MrFangao/EspressoMachine/docs/assets/Brew_Animation.jpeg

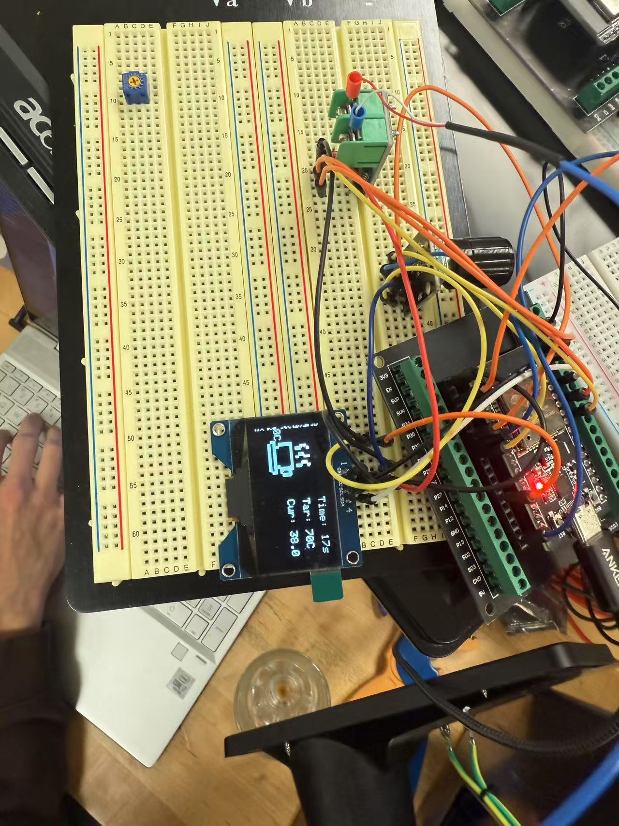
docs/assets/Brew_Animation.jpeg
