MrFangao/EspressoMachine/docs/assets/ControlMenu.jpg

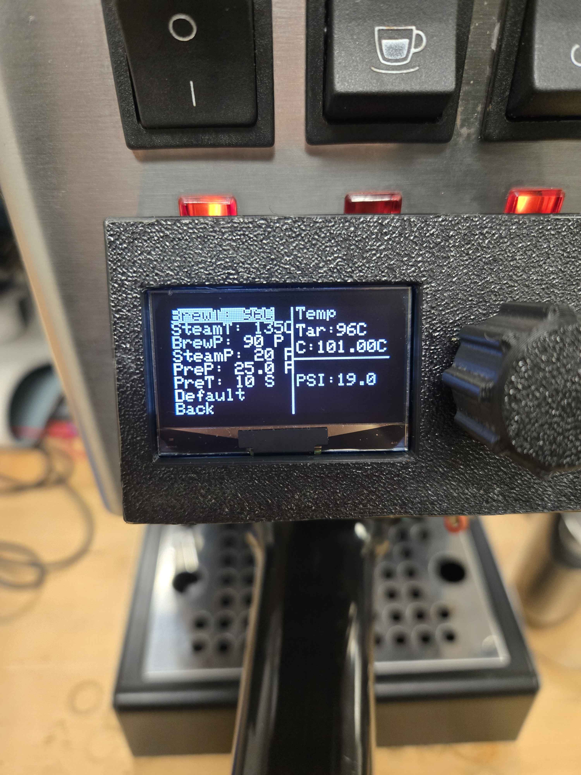
docs/assets/ControlMenu.jpg
