MrFangao/EspressoMachine/docs/assets/GaggiaMain.jpg

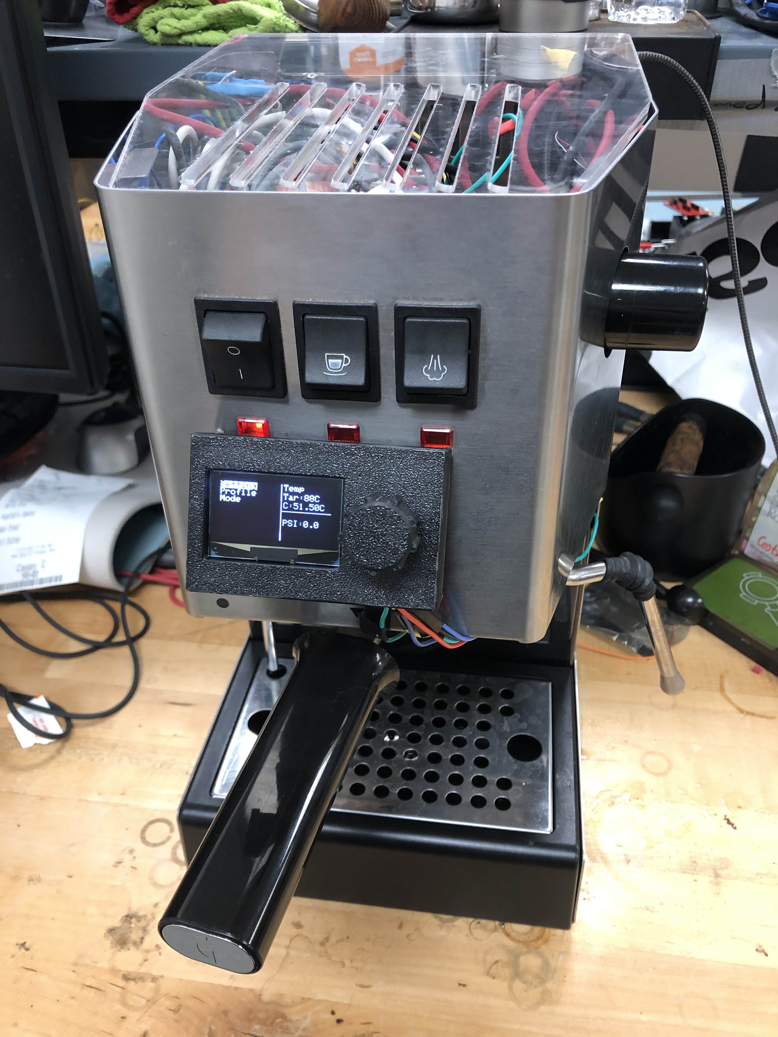
docs/assets/GaggiaMain.jpg
