MrFangao/EspressoMachine/docs/assets/Main_Status.jpeg

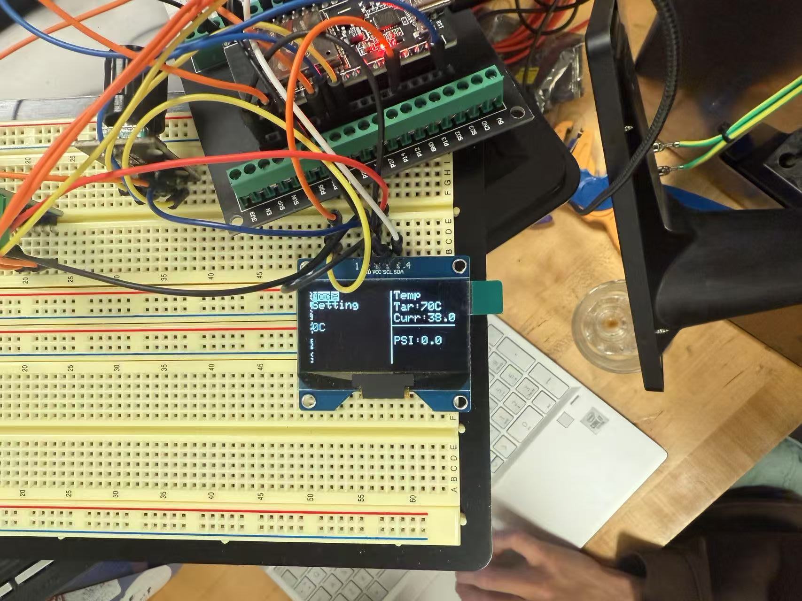
docs/assets/Main_Status.jpeg
