MrFangao/EspressoMachine/docs/assets/MainPage.jpg

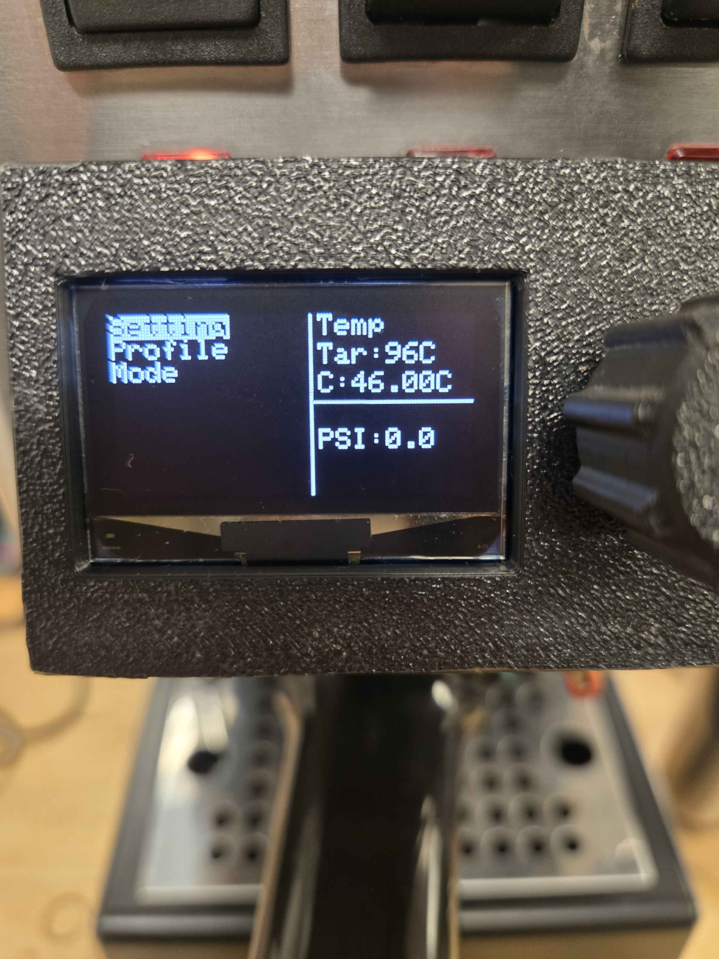
docs/assets/MainPage.jpg
