MrFangao/EspressoMachine/docs/assets/ModeMenu.jpeg

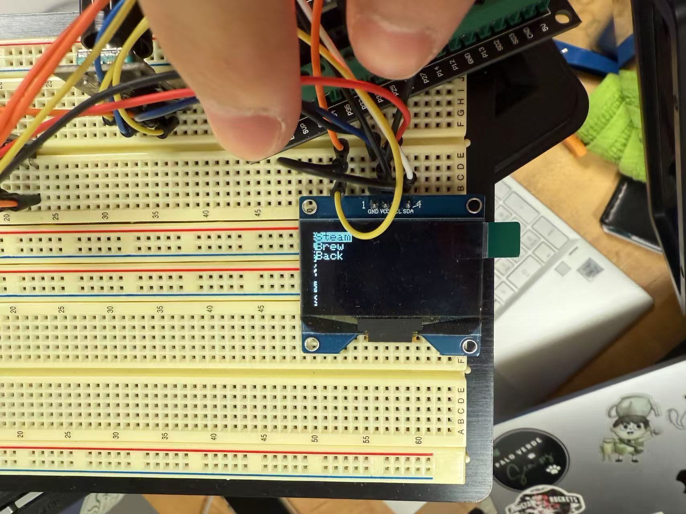
docs/assets/ModeMenu.jpeg
