MrFangao/EspressoMachine/docs/assets/OPModes.jpg

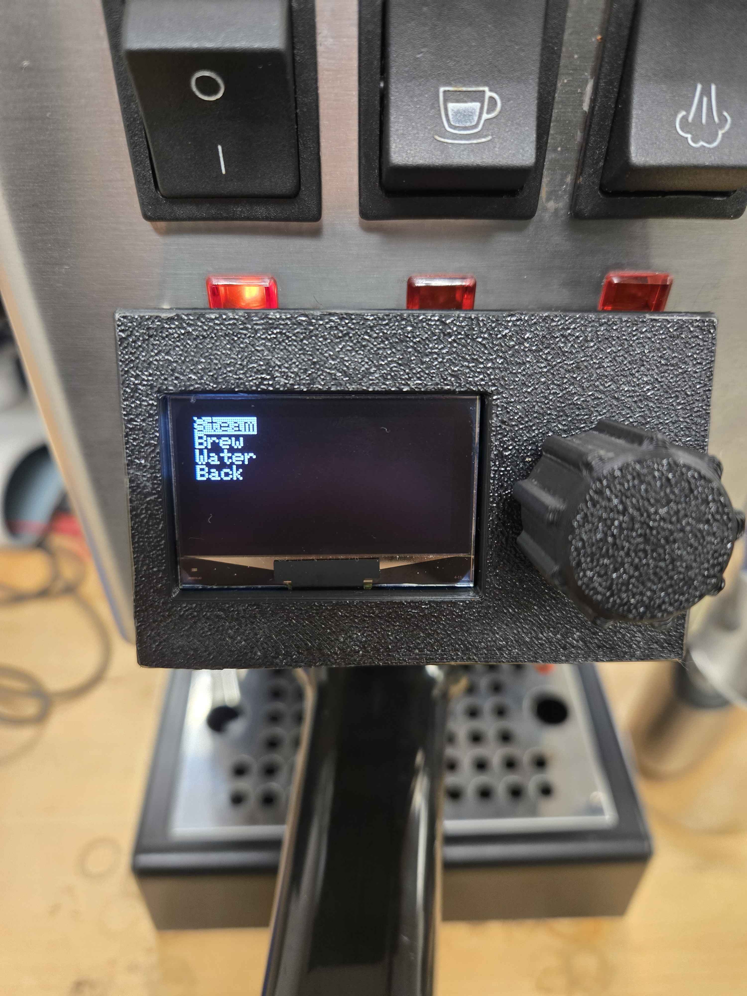
docs/assets/OPModes.jpg
