MrFangao/EspressoMachine/docs/assets/SaveOptions.jpg

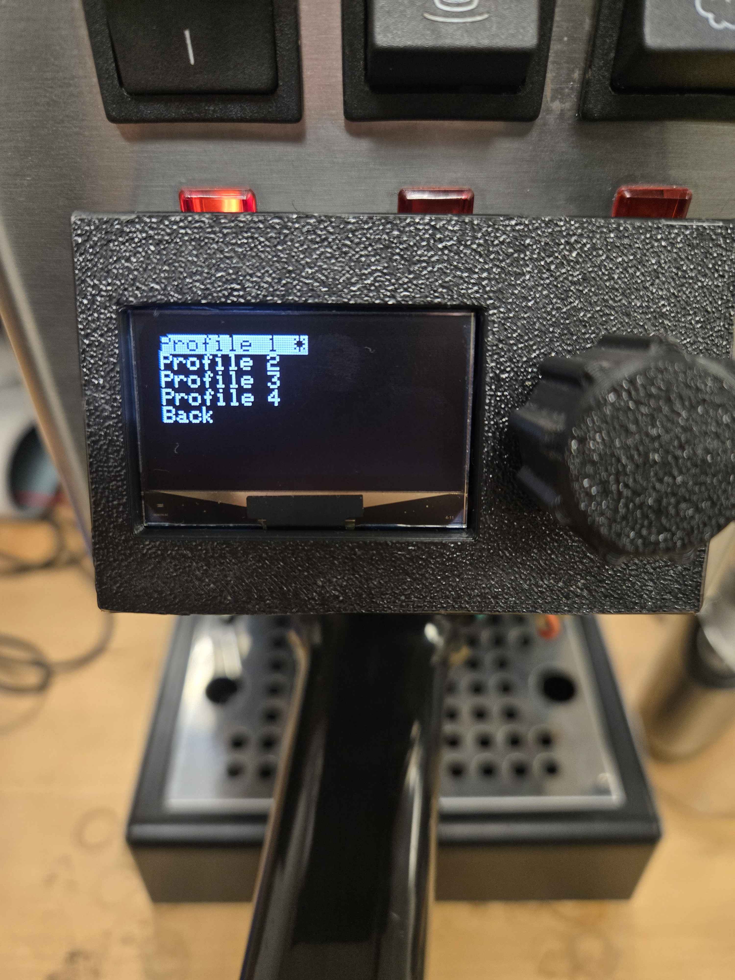
docs/assets/SaveOptions.jpg
