MrFangao/EspressoMachine/docs/assets/SettingMenu.jpeg

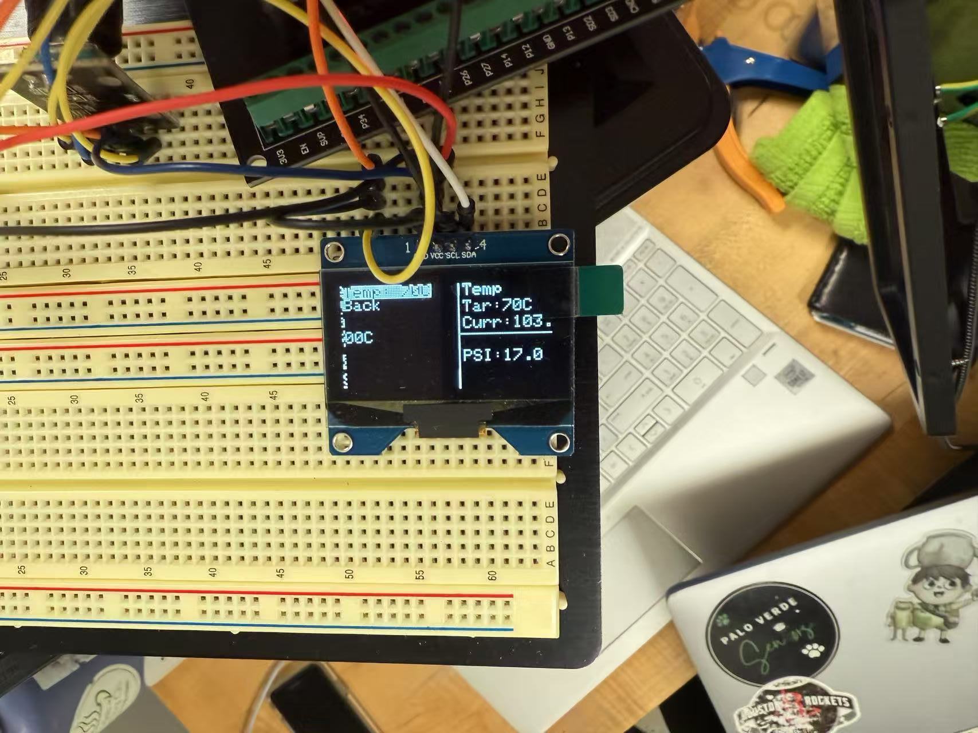
docs/assets/SettingMenu.jpeg
