MrFangao/EspressoMachine/docs/assets/Temp_Press_graph.png

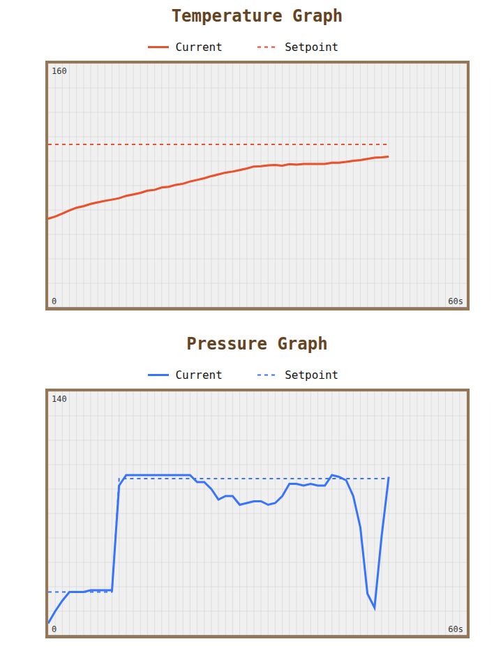
docs/assets/Temp_Press_graph.png
