MrFangao/EspressoMachine/docs/assets/TopDownView.jpg

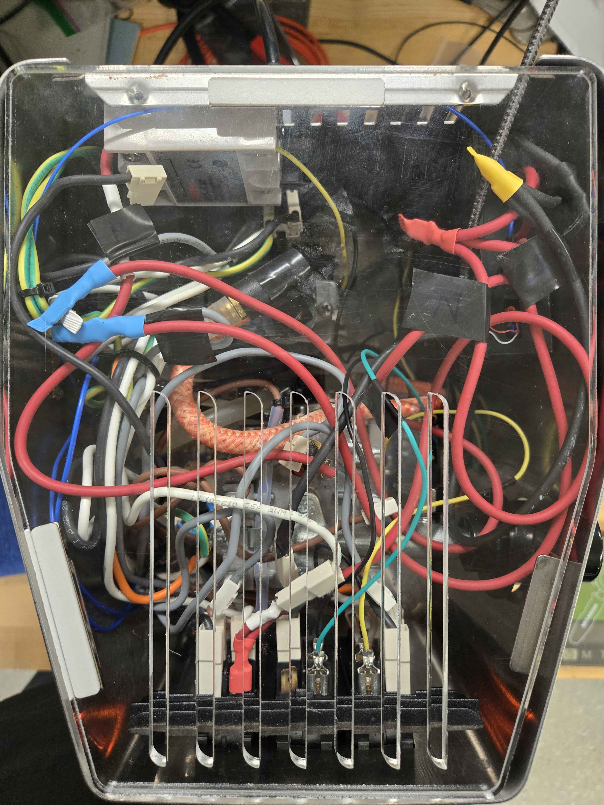
docs/assets/TopDownView.jpg
