MrFangao/EspressoMachine/docs/assets/webpage.png

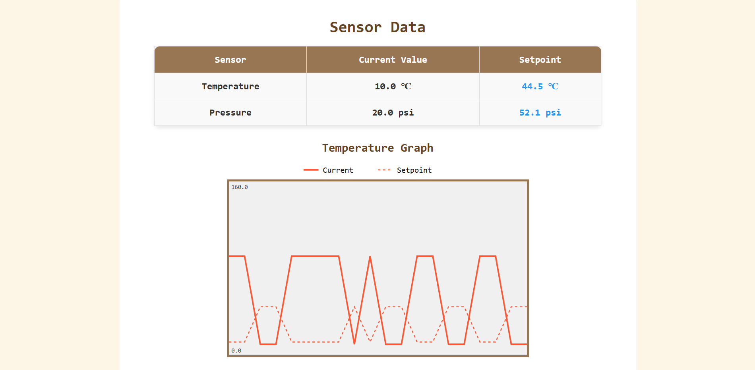
docs/assets/webpage.png
