MrFangao/EspressoMachine/docs/install.html

# How to install the Gagginator

Below is a simple guide to get started installing the Gagginator. This will require some familiarity with electronics and plumbing. This project is fairly involved at its current stage. Warning: espresso machines contain the three horrible hazards: High voltage, high pressure, and hot water. These hazards are scary on their own, and very scary when combined. Proceed at your own risk.

## Sensor Install

While installing the sensors it may be helpful to unscrew the boiler. Unscrew the 4 main bolts holding the boiler from under the group head. This can allow just enough movement of the boiler to reach the hoses and fittings more easily. Be careful not to stretch wires and hoses while doing this.

### Pressure Sensor

The pressure sensor is installed in line between the pump and the boiler. Cut a few inch long section of the new high pressure tubing and crimp the T-fitting on one side and the pressure sensor adapter on the other. Use the adapter with a gasket inside to screw on the pressure sensor.

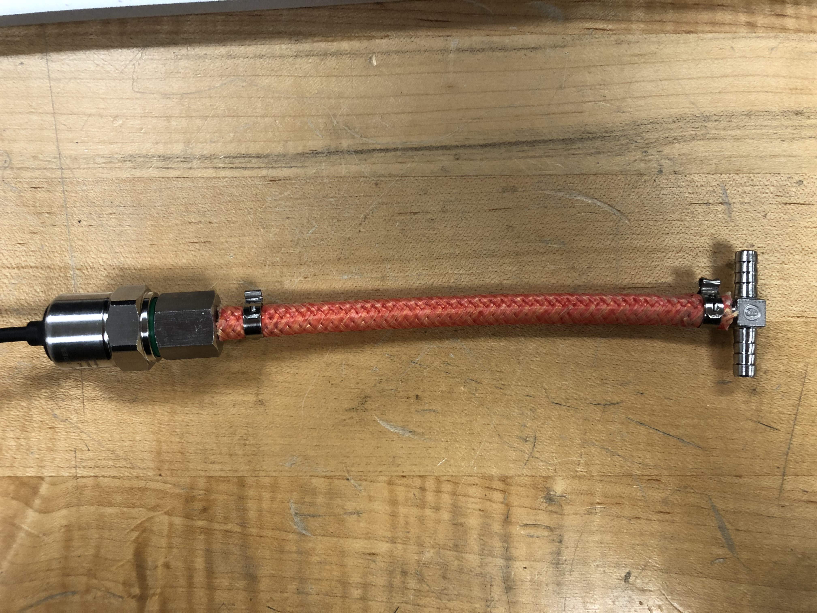
[picture p15: docs/assets/pressureSensExternal.jpg]
Pressure sensor assembly inside the machine


This is the pressure sensor assembly we will add into the machine.

Inside the machine cut the hose between the pump and the boiler in a convenient location. Remember to slide the hose clamps onto the hose before adding the T fitting of the pressure sensor assembly. Crimp the T fitting. Lay the pressure sensor somewhere out of the way at the bottom of the machine.

Pressure sensor assembly installed in the machine

The pressure sensor assembly is joined along the existing hose between the pump and boiler.

### Temperature Sensor

The thermocouple probe is installed at the bottom of the boiler on the left side, in place of the old brew thermostat. Unplug the thermostat and carefully unscrew it, as the threads are small and delicate. You may need to add thermal paste to the new thermocouple threads before gently screwing it in. Be careful not to bend the wires as you twist it, and only screw it in hand tight.

Make a small jumper to bridge the old thermostat wires together. This is shown on the schematic as well. Route the thermocouple wire and the pressure sensor wire up to join the control box later.

PLACEHOLDER IMAGE OF THERMOCOUPLE IN MACHINE AND ALSO THE JUMPER WIRES ON THE THERMOCOUPLE

The thermocouple probe screwed into the old thermostat hole. The jumper connecting the old thermostat is also shown

## Control box

The control box houses the ESP-32 and the control electronics. Follow the schematic, the pictures, and the pins.h file to wire the components inside. Use small gauge silicone wire for these connections.

The grounds of all components are soldered together and wrapped in heat shrink. The 3.3V power from the ESP-32 is split to several components and is also soldered together and wrapped in heat shrink. Ideally all connections are either screw terminals or soldered, so desolder the pin headers and solder on the new connections as needed.

The low voltage wires to the screen and heater relay exit the box through the small hole at the bottom, and the high voltage wires all exit on the right side.

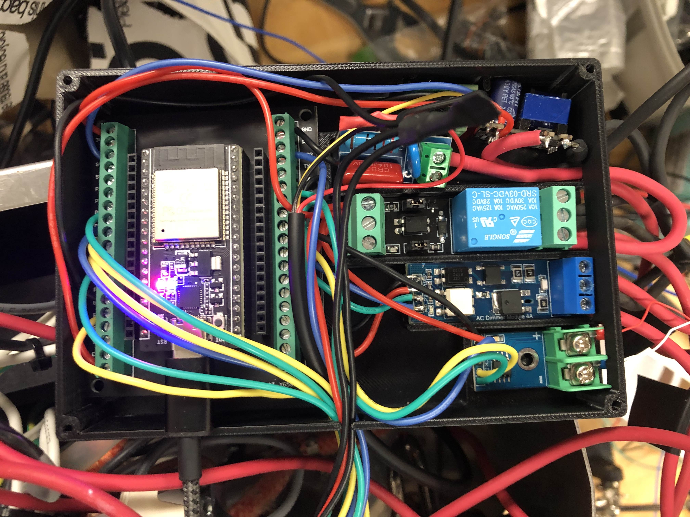
[picture p16: docs/assets/controlBoxWiring.jpg]
Control box wiring


Wiring inside the control box. In the top right is the ground connection, and underneath is the snubber, the voltage supply, and the pressure sensor voltage divider.

The pressure sensor works with a 5 volt source, so there is a voltage divider to step down to 3.3 volts for the ESP-32. Vs gets the signal pin of the pressure sensor, and Vo goes to the ADC pin of the ESP-32. This could also be made by soldering the resistors directly and wrapping in heat shrink, or on perf board.

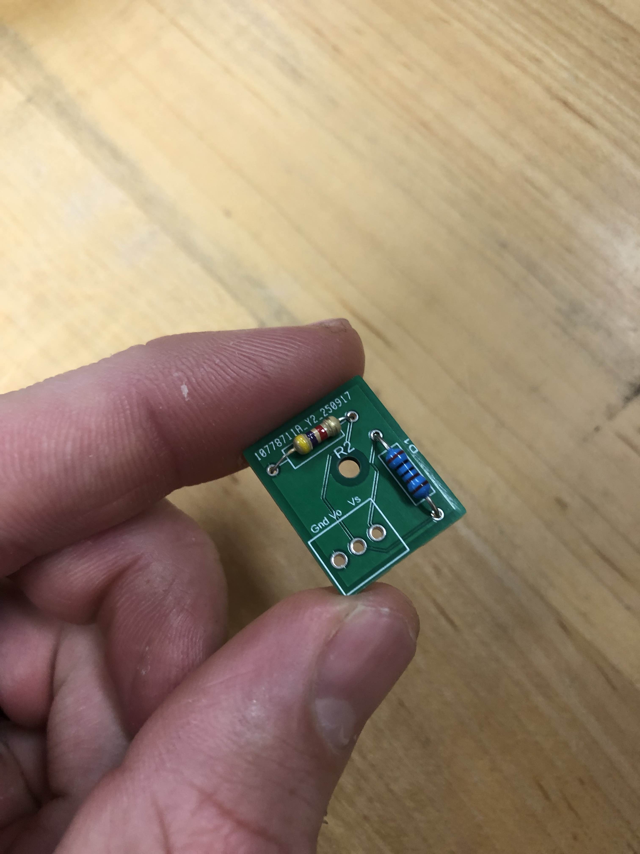
[picture p17: docs/assets/voltageDivider.jpg]
Voltage divider for pressure sensor


The voltage divider steps down the 5V from the pressure sensor to 3.3V for the ESP-32 ADC input. Vs is the sensor output, and Vo is the signal to the ESP-32.

## Screen and Knob UI Box

The front UI box houses the screen and the rotary encoder knob. Route the wires out the machine through the gap by the water tank, and solder to the screen and knob as shown in the picture.

Use a small piece of foam to squish the screen in place while you close the lid. Epoxy the bar magnets to the back of the screen bracket so the UI box magnetically sticks to the screen.

PLACEHOLDER SCREEN PICTURE

Wiring for the screen and rotary encoder knob.

## High Voltage Wiring

This section explains the high voltage wiring very completely and this is totally not placeholder text.
