MrFangao/EspressoMachine/(commit log)

2025-11-18 wrote edits for Print and Assembly Notes
2025-11-18 continue edits for print and assembly notes
2025-11-20 Add 3d print image
2025-11-20 added image and edit text for printing and assebly instructions
